makinteractlab/BodyPrinter/README.md

# BodyPrinter

BodyPrinter is a project developed at the [MAKinteract Lab](https://makinteract.kaist.ac.kr/project/bodyprinter-2020). 

## Disclaimer

Please note that this project is not currently under development and we are unable to provide additional files to those listed here. The files in this repository are offered as it - use them at your own risk. For additional information, please refer to the paper.

## Reference

Youngkyung Choi, Neung Ryu, Myung Jin Kim, Artem Dementyev, and Andrea Bianchi. 2020. BodyPrinter: Fabricating Circuits Directly on the Skin at Arbitrary Locations Using a Wearable Compact Plotter. In Proceedings of the 33rd Annual ACM Symposium on User Interface Software and Technology (UIST ‘20). Association for Computing Machinery, New York, NY, USA, 554–564. DOI:https://doi.org/10.1145/3379337.3415840
