makinteractlab/BodyPrinter/Hardware/BodyPrinter_Extruder.step

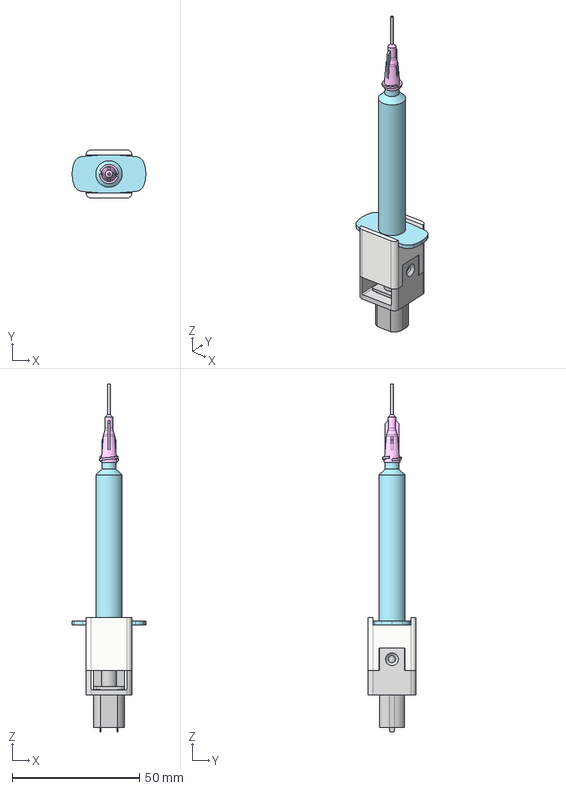
[picture p2: CAD file, 2020-07-10]
Hardware/BodyPrinter_Extruder.step
29.0 x 19.0 x 136.8 mm
Z002_GearedMotor
P008_Lid_Universal
P008_Base_Universal
P007_ScrewThread_Universal
P009_Cylinder
Z003_NiddleTip
